marxiaoxu/Two-wheeled-upright-car/README.md

# Two-wheeled upright car
 National college students intelligent car competition balance beacon group
