marxiaoxu/Two-wheeled-upright-car/smartcar/bp-neur新图像/7.20xulian(7.2)/屏幕截图 2022-07-20 182357.png

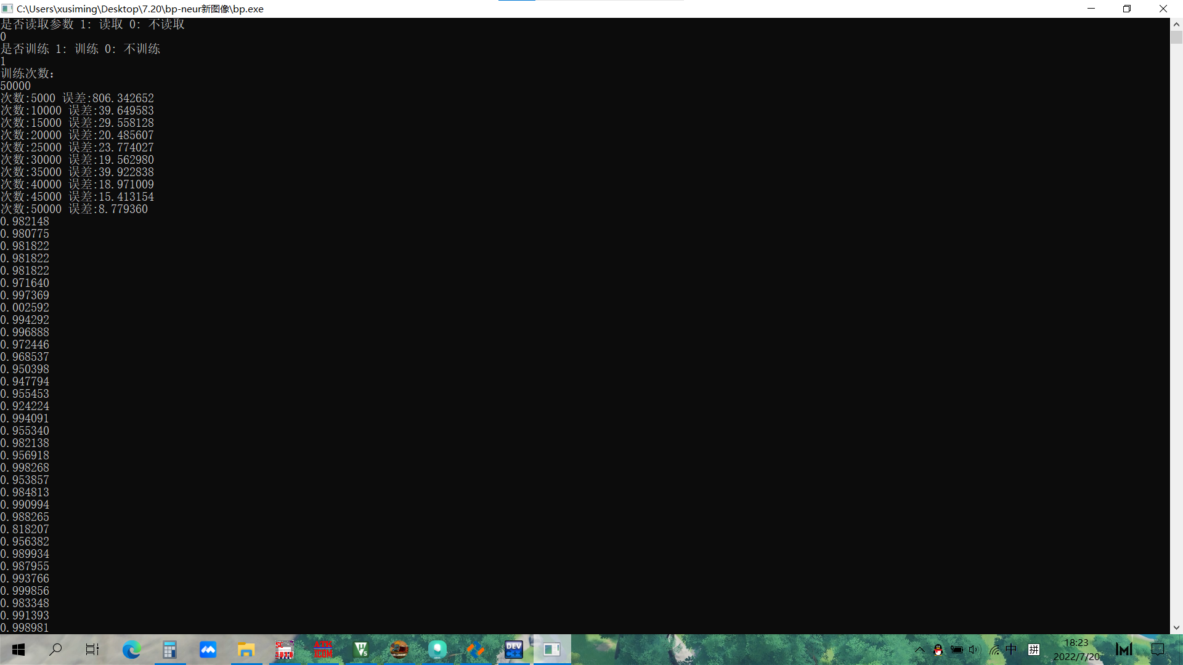
smartcar/bp-neur新图像/7.20xulian(7.2)/屏幕截图 2022-07-20 182357.png
