marxiaoxu/Two-wheeled-upright-car/smartcar/bp-neur新图像/testData.txt

143 25 134 32 138 28 121 10 36 64 
122 22 114 29 118 25 115 13 33 60 
91 20 86 28 88 24 109 14 30 54 
172 9 160 17 166 13 215 21 48 85 
186 2 178 8 181 4 149 9 29 55 
144 2 135 5 138 3 196 15 19 31 
1 2 1 2 1 2 0 0 1 1 
138 25 129 31 133 28 111 10 35 60 
117 21 109 28 113 24 104 15 30 60 
86 19 80 27 83 22 96 16 32 59 
169 10 156 17 162 13 217 23 47 85 
186 2 175 9 180 5 192 12 43 74 
140 2 130 4 134 2 182 15 17 28 
1 2 1 2 1 2 0 0 1 1 
113 23 103 30 107 26 126 10 40 65 
92 19 83 26 87 22 106 14 34 65 
61 16 54 24 57 20 96 14 38 65 
69 63 63 68 66 65 122 10 25 42 
58 64 51 69 54 66 122 10 28 43 
159 87 107 118 132 103 255 157 178 1466 
160 91 107 118 133 105 255 165 158 1319 
164 95 109 118 136 107 255 161 150 1144 
166 96 110 118 138 108 255 155 153 1020 
171 98 118 118 145 109 255 151 143 934 
36 49 30 54 33 51 102 9 25 42 
134 58 109 73 121 66 255 76 118 313 
145 61 123 75 134 67 255 78 101 272 
104 58 98 62 101 60 254 19 20 35 
92 81 40 118 65 100 255 142 188 1679 
103 82 48 118 75 101 255 154 187 1744 
110 85 52 118 80 103 255 161 186 1728 
117 86 56 118 86 104 255 166 159 1692 、
186 9 186 15 186 12 0 0 7 7 
36 8 25 18 30 13 149 37 48 115 
1 2 1 2 1 2 0 0 1 1 
15 17 6 24 11 20 81 11 36 57 
83 8 69 18 75 13 114 34 55 142 
53 8 40 17 46 12 135 37 49 128 
17 11 8 19 12 15 100 13 43 76 
1 2 1 2 1 2 0 0 1 1 
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
