marxiaoxu/Two-wheeled-upright-car/smartcar/01-ADC_Demo/USER/src/isr.c

/*********************************************************************************************************************
* COPYRIGHT NOTICE
* Copyright (c) 2019,逐飞科技
* All rights reserved.
* 技术讨论QQ群：一群：179029047(已满)  二群：244861897
*
* 以下所有内容版权均属逐飞科技所有，未经允许不得用于商业用途，
* 欢迎各位使用并传播本程序，修改内容时必须保留逐飞科技的版权声明。
*
* @file				isr
* @company			成都逐飞科技有限公司
* @author			逐飞科技(QQ3184284598)
* @version			查看doc内version文件 版本说明
* @Software			IAR 8.3 or MDK 5.28
* @Target core		MM32F3277
* @Taobao			https://seekfree.taobao.com/
* @date				2021-02-22
********************************************************************************************************************/

#include "headfile.h"
#include "isr.h"
 float angel,Yaw_Angle;
char forward_flag=3;
uint8 dat;
uint8 *data=&dat;

void TIM1_UP_IRQHandler (void)
{
	uint32 state = TIM1->SR;														// 读取中断状态	
static unsigned int TIM_COUNT_10ms=0;
TIM_COUNT_10ms++;
static unsigned int TIM_COUNT_100ms=0;
TIM_COUNT_100ms++;
static int Angle1=0;//jia
static int Angle2=0;//jiao
static float Angle=0;
static int speed=0;
static float output=0;
static	float turn=0,outturn=0;
static	int final_speed=0;

static float speed_now=0;
static int right=0,last_speed;
static float Angle_Speed=0;
static int last_output=0,map_turn_flag=0,delay=0,delay_flag=0;
static float angle_s=0;
static float time;


	{
		
		
		
			Fhan_ADRC(&ADRC_GYRO_Controller,angle_s);		
			Angle_Speed=Gyro_PID(Get_Gyro(),angle_s);//角速度环	
			turn=-In_Turn(outturn,icm_gyro_z);	//角度内环z
			pwn_out(Angle_Speed,Angle_Speed,turn);//最终、pwn输
		
		
		
	if(TIM_COUNT_10ms>=5)//角度环
	{
			TIM_COUNT_10ms=0;

		

			angel=KalmanFilter(Get_Attitude(),Get_Gyro()/65.5)+7.1-2.8;	//得出角度
			Fhan_ADRC(&ADRC_GYRO_Controller,(float)output*10); //对速度环的输出量进行TD
			angle_s=Angle_PID(angel,output,0);//角度环
			speed_now= Speed_Measure();//编码器渎职
			outturn=out_Turn((getmiddle));//角度外环z
	//	show2=speed_now;
//
	}

if(TIM_COUNT_100ms>=50)//速度环
	{	
	TIM_COUNT_100ms=0;
				
			output=Speed_PID(speed_now,Speed_PID_speed,speeed_low);//速度环输出 

	}
	

}






	TIM1->SR &= ~state;																// 清空中断状态
}
	

void TIM8_UP_IRQHandler (void)
{
	uint32 state = TIM8->SR;														// 读取中断状态
	TIM8->SR &= ~state;																// 清空中断状态
}

void TIM2_IRQHandler (void)
{
	uint32 state = TIM2->SR;														// 读取中断状态
	
	
	
	TIM2->SR &= ~state;																// 清空中断状态
}

void TIM5_IRQHandler (void)
{
	uint32 state = TIM5->SR;														// 读取中断状态

	
	TIM5->SR &= ~state;																// 清空中断状态
}

void TIM3_IRQHandler (void)
{
	uint32 state = TIM3->SR;														// 读取中断状态
	TIM3->SR &= ~state;																// 清空中断状态
}

//void TIM4_IRQHandler (void)
//{
//	uint32 state = TIM4->SR;														// 读取中断状态
//	TIM4->SR &= ~state;																// 清空中断状态
//}

void TIM6_IRQHandler (void)
{
	uint32 state = TIM6->SR;														// 读取中断状态

	


	
	


	TIM6->SR &= ~state;																// 清空中断状态
}

void TIM7_IRQHandler (void)
{
	uint32 state = TIM7->SR;														// 读取中断状态
	TIM7->SR &= ~state;																// 清空中断状态
}

void UART1_IRQHandler(void)
{
	if(UART1->ISR & UART_ISR_TX_INTF)												// 串口发送缓冲空中断
	{
		UART1->ICR |= UART_ICR_TXICLR;												// 清除中断标志位
	}
	if(UART1->ISR & UART_ISR_RX_INTF)												// 串口接收缓冲中断
	{
		if(uart_query(UART_1,data))
		{
			if(*data==1)
			{
				forward_flag=1;
				printf("forward_flag=%-5d\n",forward_flag);
			}
			else if(*data==2)
			{
				forward_flag=2;
				printf("forward_flag=%-5d\n",forward_flag);
			}
			else if(*data==3)
			{
			 forward_flag=3;			
			}
			else if(*data==4)
			{ 
			  forward_flag=4;				
			}
			else if(*data==5)
			{
			 forward_flag=5;			
			}
			else if(*data==6)
			{ 
			  forward_flag=6;				
			}
		}
		UART1->ICR |= UART_ICR_RXICLR;												// 清除中断标志位
	}
}

void UART2_IRQHandler(void)
{
	if(UART2->ISR & UART_ISR_TX_INTF)												// 串口发送缓冲空中断
	{
		UART2->ICR |= UART_ICR_TXICLR;												// 清除中断标志位
	}
	if(UART2->ISR & UART_ISR_RX_INTF)												// 串口接收缓冲中断
	{
		UART2->ICR |= UART_ICR_RXICLR;												// 清除中断标志位
	}
}

void UART3_IRQHandler(void)
{
	if(UART3->ISR & UART_ISR_TX_INTF)												// 串口发送缓冲空中断
	{
		UART3->ICR |= UART_ICR_TXICLR;												// 清除中断标志位
	}
	if(UART3->ISR & UART_ISR_RX_INTF)												// 串口接收缓冲中断
	{
		UART3->ICR |= UART_ICR_RXICLR;												// 清除中断标志位
	}
}

void UART4_IRQHandler(void)
{
	if(UART4->ISR & UART_ISR_TX_INTF)												// 串口发送缓冲空中断
	{
		UART4->ICR |= UART_ICR_TXICLR;												// 清除中断标志位
	}
	if(UART4->ISR & UART_ISR_RX_INTF)												// 串口接收缓冲中断
	{
		UART4->ICR |= UART_ICR_RXICLR;												// 清除中断标志位
	}
}

void UART5_IRQHandler(void)
{
	if(UART5->ISR & UART_ISR_TX_INTF)												// 串口发送缓冲空中断
	{
		UART5->ICR |= UART_ICR_TXICLR;												// 清除中断标志位
	}
	if(UART5->ISR & UART_ISR_RX_INTF)												// 串口接收缓冲中断
	{
		UART5->ICR |= UART_ICR_RXICLR;												// 清除中断标志位
	}
}

void UART6_IRQHandler(void)
{
	if(UART6->ISR & UART_ISR_TX_INTF)												// 串口发送缓冲空中断
	{
		UART6->ICR |= UART_ICR_TXICLR;												// 清除中断标志位
	}
	if(UART6->ISR & UART_ISR_RX_INTF)												// 串口接收缓冲中断
	{
		UART6->ICR |= UART_ICR_RXICLR;												// 清除中断标志位
	}
}

void UART7_IRQHandler(void)
{
	if(UART7->ISR & UART_ISR_TX_INTF)												// 串口发送缓冲空中断
	{
		UART7->ICR |= UART_ICR_TXICLR;												// 清除中断标志位
	}
	if(UART7->ISR & UART_ISR_RX_INTF)												// 串口接收缓冲中断
	{
		UART7->ICR |= UART_ICR_RXICLR;												// 清除中断标志位
	}
}

void UART8_IRQHandler(void)
{
	if(UART8->ISR & UART_ISR_TX_INTF)												// 串口发送缓冲空中断
	{
		UART8->ICR |= UART_ICR_TXICLR;												// 清除中断标志位
	}
	if(UART8->ISR & UART_ISR_RX_INTF)												// 串口接收缓冲中断
	{
		UART8->ICR |= UART_ICR_RXICLR;												// 清除中断标志位
		switch(camera_type)															// 查询摄像头类型 未初始化摄像头则此处会进入default
		{
			case CAMERA_BIN_UART: 													// 串口小钻风
				ov7725_cof_uart_interrupt();										// 调用串口小钻风的串口接收处理
				break;
			case CAMERA_GRAYSCALE: 													// 总钻风
				mt9v03x_uart_callback();											// 调用总钻风的串口接收处理
				break;
			default:
				break;
		}
	}
}

void EXTI0_IRQHandler(void)
{
	// 检测与清除中断标志可以根据实际应用进行删改
	EXTI_ClearFlag(EXTI_Line0);														// 清除 line0 触发标志
}

void EXTI1_IRQHandler(void)
{
	// 检测与清除中断标志可以根据实际应用进行删改
	EXTI_ClearFlag(EXTI_Line1);														// 清除 line1 触发标志
}

void EXTI2_IRQHandler(void)
{
	// 检测与清除中断标志可以根据实际应用进行删改
	EXTI_ClearFlag(EXTI_Line2);														// 清除 line2 触发标志
}

void EXTI3_IRQHandler(void)
{
	// 检测与清除中断标志可以根据实际应用进行删改
	EXTI_ClearFlag(EXTI_Line3);														// 清除 line3 触发标志
}

void EXTI4_IRQHandler(void)
{
	// 检测与清除中断标志可以根据实际应用进行删改
	EXTI_ClearFlag(EXTI_Line4);														// 清除 line4 触发标志
}

void EXTI9_5_IRQHandler(void)
{
	// 检测与清除中断标志可以根据实际应用进行删改
	if(EXTI_GetITStatus(EXTI_Line5))												// 检测 line5 是否触发
	{
		EXTI_ClearFlag(EXTI_Line5);													// 清除 line5 触发标志
	}
	if(EXTI_GetITStatus(EXTI_Line6))												// 检测 line6 是否触发
	{
		EXTI_ClearFlag(EXTI_Line6);													// 清除 line6 触发标志
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
{
	if(SET == DMA_GetFlagStatus(DMA2_FLAG_TC2))										// 判断触发通道
	{
		DMA_ClearFlag(DMA2_FLAG_TC2);												// 清空该通道中断标志
	}
}

void DMA2_Channel3_IRQHandler(void)
{
	if(SET == DMA_GetFlagStatus(DMA2_FLAG_TC3))										// 判断触发通道
	{
		DMA_ClearFlag(DMA2_FLAG_TC3);												// 清空该通道中断标志
	}
}

void DMA2_Channel4_IRQHandler(void)
{
	if(SET == DMA_GetFlagStatus(DMA2_FLAG_TC4))										// 判断触发通道
	{
		DMA_ClearFlag(DMA2_FLAG_TC4);												// 清空该通道中断标志
	}
}

void DMA2_Channel5_IRQHandler(void)
{
	if(SET == DMA_GetFlagStatus(DMA2_FLAG_TC5))										// 判断触发通道
	{
		DMA_ClearFlag(DMA2_FLAG_TC5);												// 清空该通道中断标志
	}
}

#ifdef Will_never_be_defined
WWDG_IRQHandler
PVD_IRQHandler
TAMPER_IRQHandler
RTC_IRQHandler
FLASH_IRQHandler
RCC_CRS_IRQHandler
EXTI0_IRQHandler
EXTI1_IRQHandler
EXTI2_IRQHandler
EXTI3_IRQHandler
EXTI4_IRQHandler
DMA1_Channel1_IRQHandler
DMA1_Channel2_IRQHandler
DMA1_Channel3_IRQHandler
DMA1_Channel4_IRQHandler
DMA1_Channel5_IRQHandler
DMA1_Channel6_IRQHandler
DMA1_Channel7_IRQHandler
ADC1_2_IRQHandler
FlashCache_IRQHandler
CAN1_RX_IRQHandler
EXTI9_5_IRQHandler
TIM1_BRK_IRQHandler
TIM1_UP_IRQHandler
TIM1_TRG_COM_IRQHandler
TIM1_CC_IRQHandler
TIM2_IRQHandler
TIM3_IRQHandler
//TIM4_IRQHandler
I2C1_IRQHandler
I2C2_IRQHandler
SPI1_IRQHandler
SPI2_IRQHandler
UART1_IRQHandler
UART2_IRQHandler
UART3_IRQHandler
EXTI15_10_IRQHandler
RTCAlarm_IRQHandler
OTG_FS_WKUP_IRQHandler
TIM8_BRK_IRQHandler
TIM8_UP_IRQHandler
TIM8_TRG_COM_IRQHandler
TIM8_CC_IRQHandler
ADC3_IRQHandler
SDIO_IRQHandler
TIM5_IRQHandler
SPI3_IRQHandler
UART4_IRQHandler
UART5_IRQHandler
TIM6_IRQHandler
TIM7_IRQHandler
DMA2_Channel1_IRQHandler
DMA2_Channel2_IRQHandler
DMA2_Channel3_IRQHandler
DMA2_Channel4_IRQHandler
DMA2_Channel5_IRQHandler
ETH_IRQHandler
COMP1_2_IRQHandler
OTG_FS_IRQHandler
UART6_IRQHandler
UART7_IRQHandler
UART8_IRQHandler
#endif
