marxiaoxu/Two-wheeled-upright-car/smartcar/01-ADC_Demo/CODE/bp.c

#include "bp.h"
/**************修改如下值*******************/
#define In 10    //输入层In个节点
#define Hide 48  //隐藏层Hide个节点
#define Out 1   //输出层Out个节点
#define Out_divisor  1.0 //输出除数 保持所有输出数据在-1~1内
//double weight_IH[10][48]=   //7.20   
//{
//-0.600000 ,0.054172 ,0.200000 ,0.485469 ,0.870829 ,-0.800000 ,0.100000 ,-0.400000 ,0.943534 ,-0.600000 ,-0.200000 ,0.052097 ,-1.000000 ,0.000000 ,0.700000 ,-0.972628 ,-0.500000 ,0.775230 ,0.402580 ,-0.101334 ,-0.977597 ,-0.600000 ,0.330960 ,0.708439 ,0.700000 ,-0.600000 ,0.512224 ,0.699987 ,0.643614 ,0.613623 ,0.977018 ,-0.564408 ,-0.682524 ,-0.900000 ,-1.054880 ,0.674744 ,-0.100000 ,-0.116196 ,0.894926 ,0.259690 ,-0.179634 ,-0.427146 ,-0.600000 ,-0.200000 ,-0.843805 ,0.400000 ,-0.400122 ,0.145020 ,
//-0.900000 ,-1.094515 ,-0.200000 ,0.641040 ,-0.514589 ,0.000000 ,0.600000 ,0.100000 ,0.925041 ,-0.700000 ,0.200000 ,-0.448758 ,-0.100000 ,0.900000 ,0.800000 ,0.317357 ,0.100000 ,0.887502 ,0.400801 ,-1.000815 ,-1.048561 ,-0.700000 ,0.638353 ,0.549138 ,0.600000 ,-0.600000 ,0.207239 ,0.199996 ,-0.577846 ,1.005900 ,-0.569187 ,-0.435028 ,-0.055023 ,0.200000 ,0.049874 ,0.545797 ,-0.100000 ,0.732638 ,0.698305 ,-0.863903 ,-0.239168 ,0.738747 ,0.300000 ,0.500000 ,0.600860 ,0.600000 ,0.699926 ,0.448059 ,
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
{
    int i;
    double hide[Hide] = {0};
    for(i=0;i<Hide;i++) {
        hide[i] = getOneNodeValue(data, In, *weight_IH+i, Hide, bias_H[i]); 
    }
    for(i=0;i<Out;i++) {
        output[i] = getOneNodeValue(hide, Hide, *weight_HO+i, Out, bias_O[i]) * Out_divisor; 
    }
}
