marxiaoxu/Two-wheeled-upright-car/smartcar/01-ADC_Demo/CODE/OTSU.h

#ifndef _OTSU_H_
#define _OTSU_H_
#include "headfile.h"

int MyOSTU(int width,int height,unsigned char *Image);
float process_curvity(int x1, int y1, int x2, int y2, int x3, int y3);
#endif /*MYOTSU_H_*/
