marxiaoxu/Two-wheeled-upright-car/smartcar/01-ADC_Demo/CODE/Template_matching.h

#ifndef _Template_mathcing_h
#define _Template_mathcing_h
#include "headfile.h"
static const unsigned char circle_temple_bin[19][19]={
        {  0,  0,  0,  0,  0,  0,  0,  0,  0,255,  0,  0,  0,  0,  0,  0,  0,  0,  0,},
        {  0,  0,  0,  0,  0,255,255,255,255,255,255,255,255,255,  0,  0,  0,  0,  0,},
        {  0,  0,  0,  0,255,255,255,255,255,255,255,255,255,255,255,  0,  0,  0,  0,},
        {  0,  0,  0,255,255,255,255,255,255,255,255,255,255,255,255,255,  0,  0,  0,},
        {  0,  0,255,255,255,255,255,255,255,255,255,255,255,255,255,255,255,  0,  0,},
        {  0,255,255,255,255,255,255,255,255,255,255,255,255,255,255,255,255,255,  0,},
        {  0,255,255,255,255,255,255,255,255,255,255,255,255,255,255,255,255,255,  0,},
        {  0,255,255,255,255,255,255,255,255,255,255,255,255,255,255,255,255,255,  0,},
        {  0,255,255,255,255,255,255,255,255,255,255,255,255,255,255,255,255,255,  0,},
        {255,255,255,255,255,255,255,255,255,255,255,255,255,255,255,255,255,255,255,},
        {  0,255,255,255,255,255,255,255,255,255,255,255,255,255,255,255,255,255,  0,},
        {  0,255,255,255,255,255,255,255,255,255,255,255,255,255,255,255,255,255,  0,},
        {  0,255,255,255,255,255,255,255,255,255,255,255,255,255,255,255,255,255,  0,},
        {  0,255,255,255,255,255,255,255,255,255,255,255,255,255,255,255,255,255,  0,},
        {  0,  0,255,255,255,255,255,255,255,255,255,255,255,255,255,255,255,  0,  0,},
        {  0,  0,  0,255,255,255,255,255,255,255,255,255,255,255,255,255,  0,  0,  0,},
        {  0,  0,  0,  0,255,255,255,255,255,255,255,255,255,255,255,  0,  0,  0,  0,},
        {  0,  0,  0,  0,  0,255,255,255,255,255,255,255,255,255,  0,  0,  0,  0,  0,},
        {  0,  0,  0,  0,  0,  0,  0,  0,  0,255,  0,  0,  0,  0,  0,  0,  0,  0,  0,},
};



#endif
