marxiaoxu/Two-wheeled-upright-car/smartcar/01-ADC_Demo/CODE/pengzhang.h

#ifndef _PENGZHANG_H
#define _PENGZHANG_H
#include "headfile.h"
void pengzhang(unsigned char *Image);
void pengzhang2(unsigned char Image[][188]); 
unsigned char conv_bin_special(const unsigned char img[120][188],unsigned char out[120][188]);
#endif
