marxiaoxu/Two-wheeled-upright-car/(notices)

Notices in the files:
smartcar/01-ADC_Demo/USER/src/main.c:
Copyright (c) 2019,Öð·É¿Æ¼¼
All rights reserved.
